bangelooo/BanSCARA/CAD Model/SCARA-Q2.step

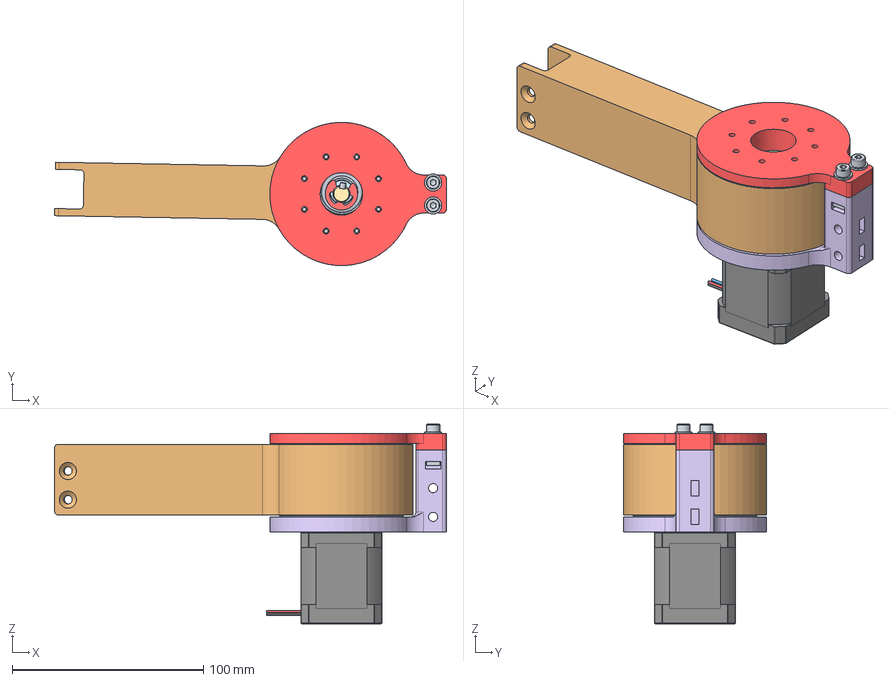
[picture p1: CAD file, 2026-09-29]
CAD Model/SCARA-Q2.step
205.2 x 75.0 x 104.5 mm
4668K163_Permanently Lubricated Stainless Steel Ball Bearing x 20
3m x 40mm LG Pin x 8
Gear Reducer Base
Rotating Module
Top Bracket
17HS19-2004S1 x 3
Square thin nut grade B M4x0.7 x 2
Hex socket head cap screw M3x0.50 x 10
Hex socket head cap screw M4x0.70 x 16 x 2
Conical spring lock washer M4 x 2
Eccentric Shaft
19 Lobe Cycloidal Disc x 2
5972K287_Ball Bearing x 24
Eccentric Roller
Parallel key A x 3 x 3 x 8
Cup point hex socket set screw M3x0.5 x 6
E-Ring - 9mm Shaft
Square thin nut grade B M3x0.5
