bangelooo/BanSCARA/CAD Model/SCARA-Q1.step

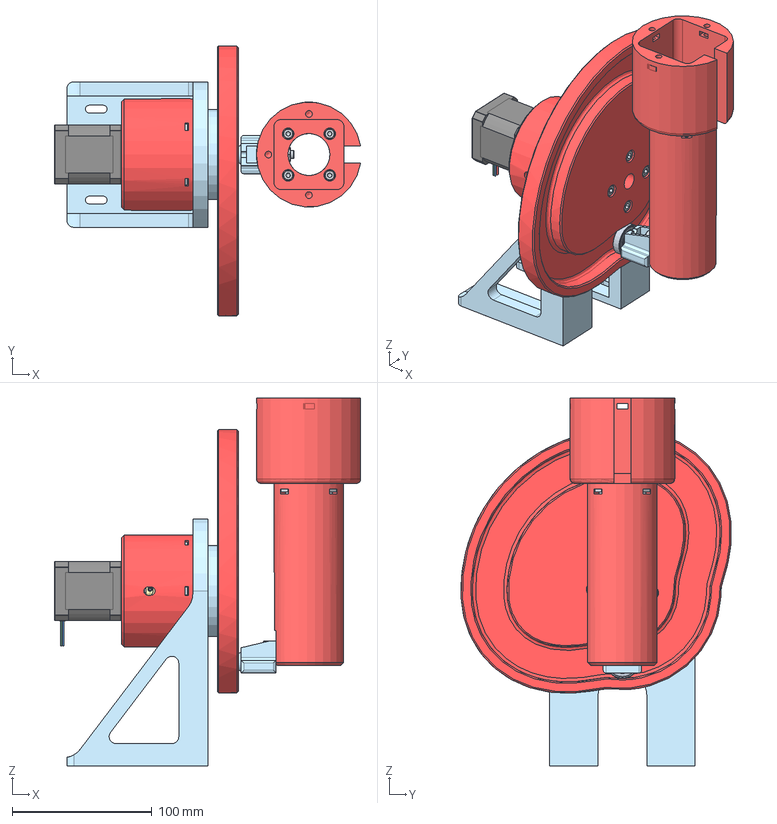
[picture p2: CAD file, 2026-09-29]
CAD Model/SCARA-Q1.step
219.0 x 193.1 x 263.0 mm
Spring lock washer A4 x 7
Spring lock washer A5 x 7
Hex socket head cap screw M4x0.70 x 10 x 7
Hex socket head cap screw M5x0.80 x 16 x 7
Hex socket head cap screw M3x0.50 x 12 x 6
Cycloidal Motion Cam
Spring lock washer A3 x 2
BRKT,GB,CYCL,Q1
ruthex RX-M5x9,5 x 4
ADPT,GB-TO-CAM
Hex socket head cap screw M4x0.70 x 16 x 4
Square thin nut grade B M4x0.7 x 4
Z-Shaft
Hex nut grade A & B M6x1
E-Ring - 9mm Shaft x 2
5972K287_Ball Bearing x 48
Hex socket head cap screw M6x1.00 x 16
Cam follower 2
Coupling | q2 to Z-Shaft
3m x 40mm LG Pin x 8
Square thin nut grade B M3x0.5 x 7
Stator-Base
93448A109_Low-Clearance External Retaining Rings
98455A124_Internal Retaining Ring
Cup point hex socket set screw M3x0.5 x 6
19 Lobe Cycloidal Disc x 2
Eccentric Shaft
Parallel key A x 3 x 3 x 8
Eccentric Roller
17HS19-2004S1 x 3
Hex socket head cap screw M3x0.50 x 8
Rotor - Bottom
4668K163_Permanently Lubricated Stainless Steel Ball Bearing x 10
RX-M4x8.1 x 4
Rotor - Top
