bangelooo/BanSCARA/CAD Model/SCARA-Q4.step

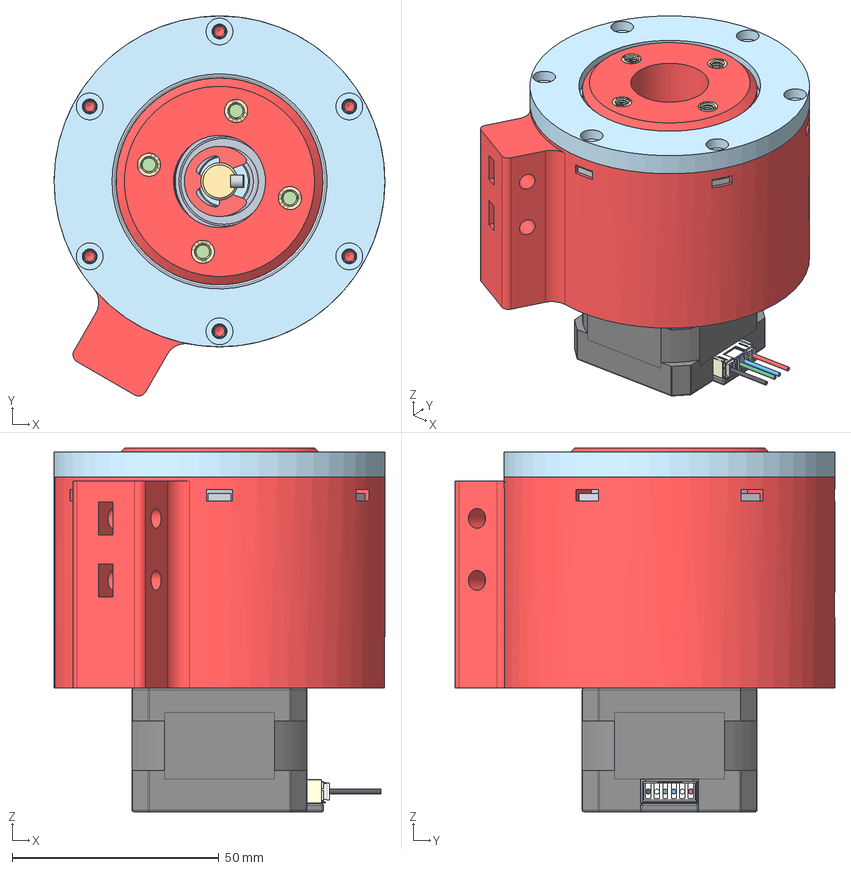
[picture p3: CAD file, 2026-09-29]
CAD Model/SCARA-Q4.step
80.0 x 91.9 x 88.0 mm
3m x 40mm LG Pin x 8
Square thin nut grade B M3x0.5 x 7
17HE12-1204S
93448A109_Low-Clearance External Retaining Rings
98455A124_Internal Retaining Ring
5972K287_Ball Bearing x 36
RX-M4x8.1 x 4
Rotor - Top
Rotor - Bottom
Stator-Base
Eccentric Shaft
Cup point hex socket set screw M3x0.5 x 6
Eccentric Roller
Parallel key A x 3 x 3 x 8
E-Ring - 9mm Shaft
19 Lobe Cycloidal Disc x 2
4668K163_Permanently Lubricated Stainless Steel Ball Bearing x 10
