bangelooo/BanSCARA/CAD Model/End Effector.step

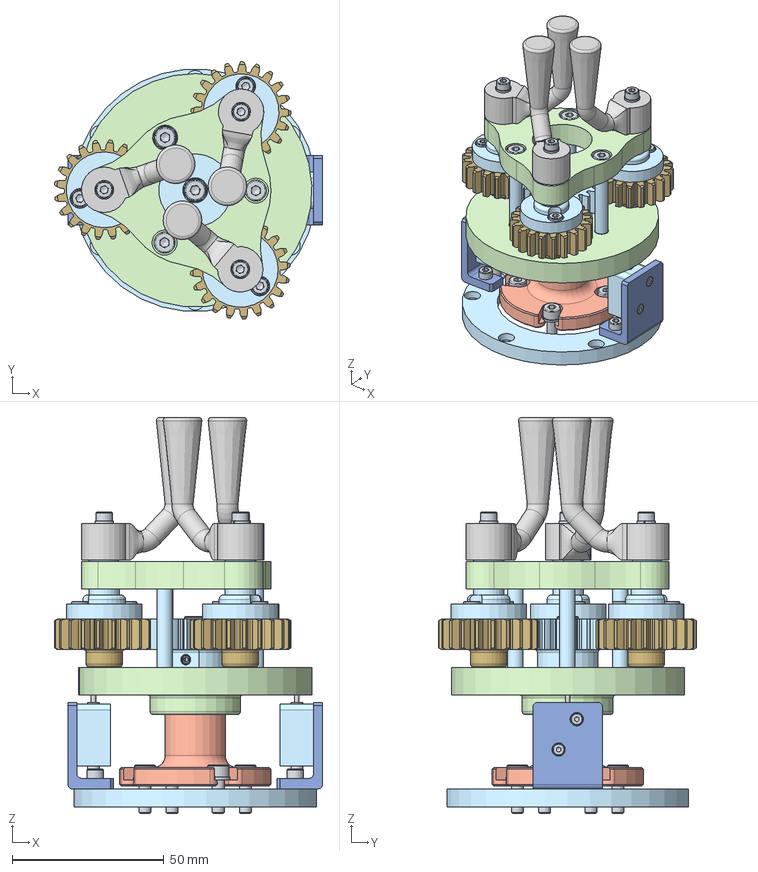
[picture p4: CAD file, 2026-09-29]
CAD Model/End Effector.step
88.4 x 84.9 x 130.6 mm
Hex socket head cap screw M4x0.70 x 12 x 5
Hex socket head cap screw M3x0.50 x 10 x 9
Hex socket head cap screw M2x0.40 x 4 x 4
Cup point hex socket set screw M3x0.5 x 6
Spring lock washer A3 x 9
Spring lock washer A4 x 9
Spur gear (20 teeth) x 4
Square thin nut grade B M3x0.5
5972K287_Ball Bearing x 12
EE - Base Flange V2
RX-M4x8.1 x 4
ruthex RX-M3-5,7 x 13
Finger Base x 3
Finger x 3
Hex socket head cap screw M3x0.50 x 5 x 4
Solenoid Body x 2
Solenoid Shaft x 2
Bracket x 2
END EFFECTOR COVER
Square thin nut grade B M4x0.7 x 3
Hex socket head cap screw M4x0.70 x 40 x 20 x 3
Planet Carrier Bottom
Planet Carrier Spacer x 3
Hex socket head cap screw M4x0.70 x 20 x 3
Planet Carrier
