bangelooo/BanSCARA/CAD Model/Robot.step

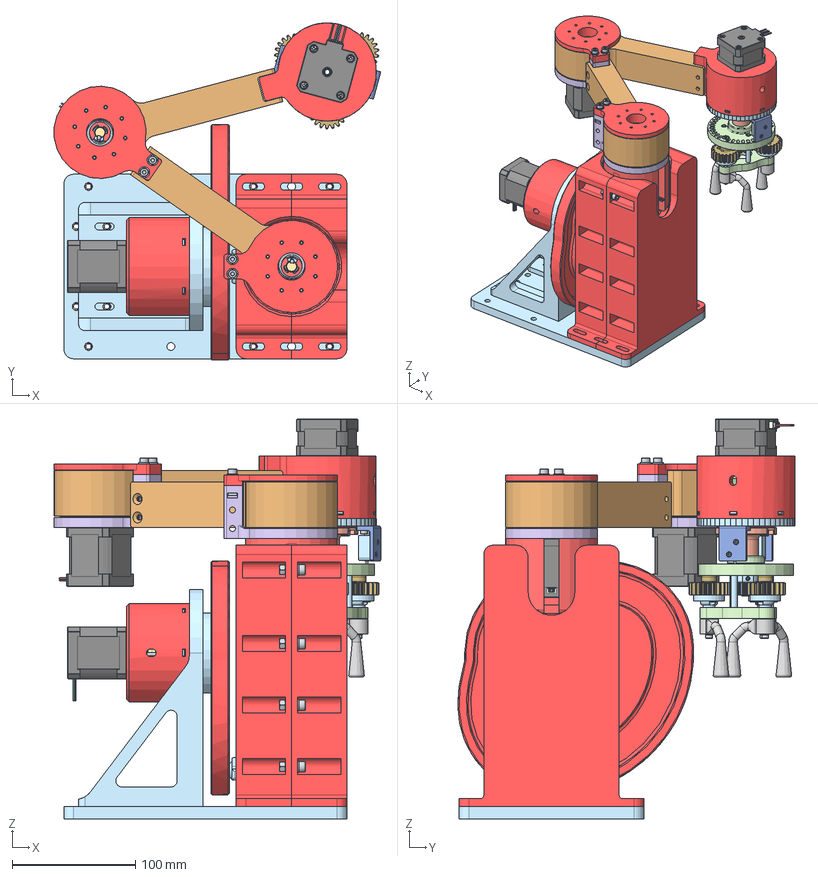
[picture p5: CAD file, 2026-09-29]
CAD Model/Robot.step
265.4 x 274.1 x 325.0 mm
Conical spring lock washer M4 x 4
Hex socket head cap screw M3x0.50 x 10 x 17
17HS19-2004S1 x 9
3m x 40mm LG Pin x 32
4668K163_Permanently Lubricated Stainless Steel Ball Bearing x 60
Square thin nut grade B M4x0.7 x 11
Hex socket head cap screw M4x0.70 x 16 x 8
Top Bracket x 2
Gear Reducer Base x 2
Rotating Module x 2
5972K287_Ball Bearing x 144
Cup point hex socket set screw M3x0.5 x 6 x 5
Eccentric Roller x 4
19 Lobe Cycloidal Disc x 8
E-Ring - 9mm Shaft x 5
Eccentric Shaft x 4
Square thin nut grade B M3x0.5 x 17
Parallel key A x 3 x 3 x 8 x 4
17HE12-1204S
98455A124_Internal Retaining Ring x 2
Rotor - Bottom x 2
93448A109_Low-Clearance External Retaining Rings x 2
Rotor - Top x 2
RX-M4x8.1 x 12
Stator-Base x 2
Hex nut style 1 grade A & B M5x0.8 x 8
Spring lock washer A5 x 15
Hex socket head cap screw M5x0.80 x 16 x 15
Housing-Back
Housing-Front
ruthex RX-M5x9,5 x 20
BASE PLATE
Hex socket head cap screw M4x0.70 x 10 x 7
Hex socket head cap screw M3x0.50 x 12 x 6
Spring lock washer A4 x 16
Spring lock washer A3 x 11
BRKT,GB,CYCL,Q1
Cycloidal Motion Cam
Coupling | q2 to Z-Shaft
Z-Shaft
Hex nut grade A & B M6x1
Hex socket head cap screw M6x1.00 x 16
Cam follower 2
ADPT,GB-TO-CAM
Hex socket head cap screw M3x0.50 x 8
Hex socket head cap screw M2x0.40 x 4 x 4
Spur gear (20 teeth) x 4
Hex socket head cap screw M4x0.70 x 12 x 5
EE - Base Flange V2
Hex socket head cap screw M4x0.70 x 40 x 20 x 3
Hex socket head cap screw M4x0.70 x 20 x 3
Planet Carrier Spacer x 3
Planet Carrier Bottom
Planet Carrier
Hex socket head cap screw M3x0.50 x 5 x 4
Bracket x 2
ruthex RX-M3-5,7 x 13
END EFFECTOR COVER
Solenoid Body x 2
Solenoid Shaft x 2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
