bangelooo/BanSCARA/(list of files, cad)

Other CAD files:
CAD Model/SCARA-Q3.step
