bangelooo/BanSCARA/SCARA_PCB/SCARA_PCB.pdf

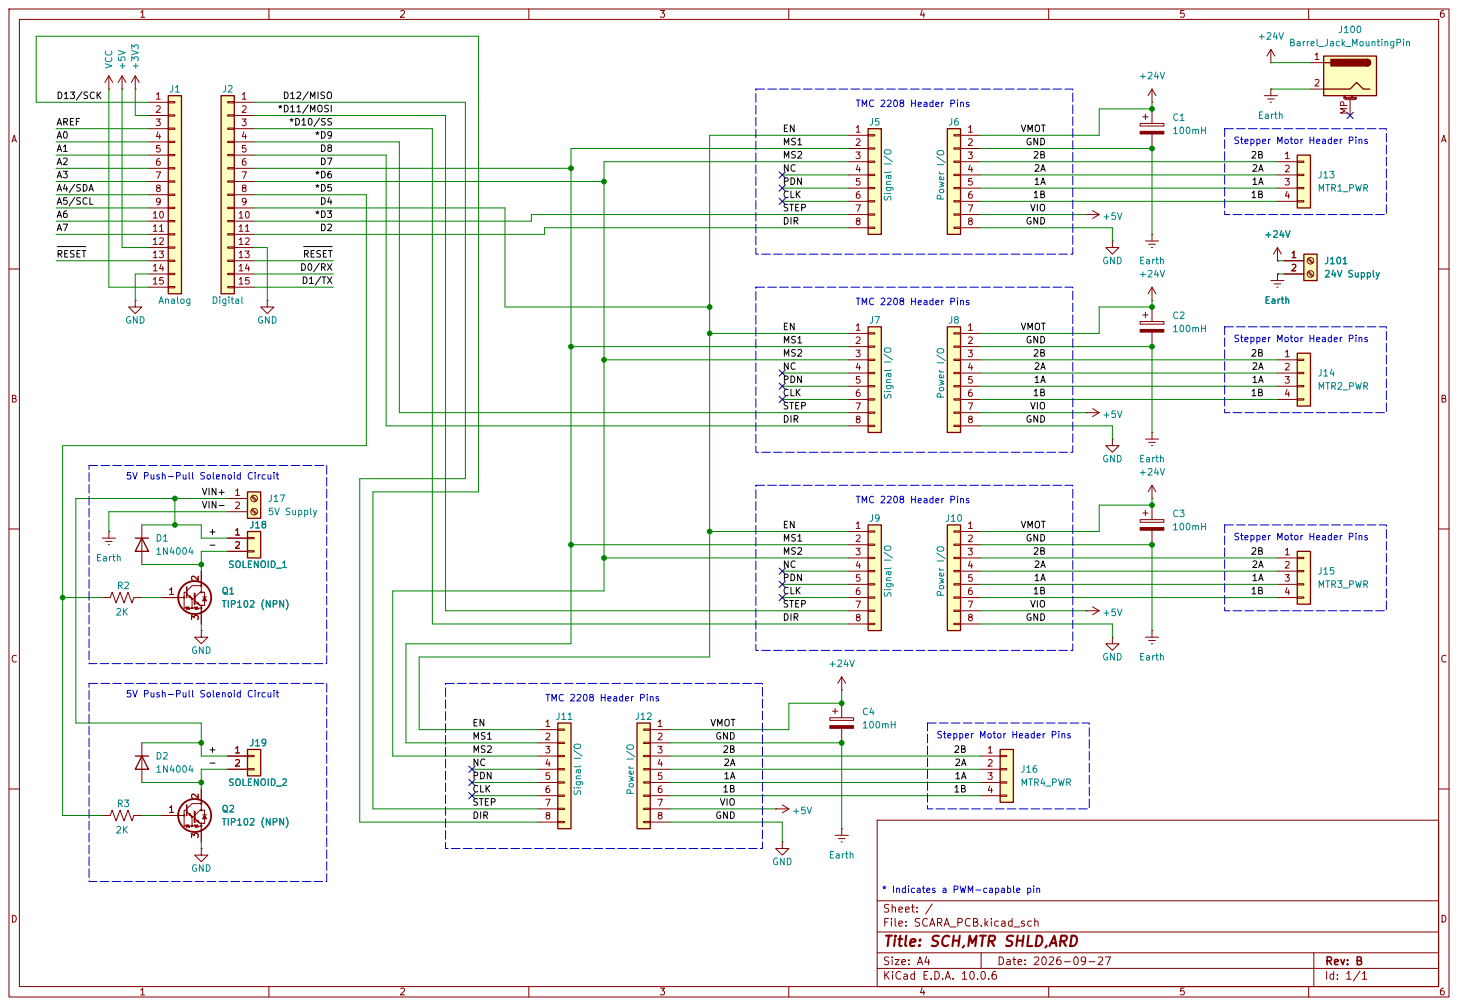
[picture p6: page 1]

Stepper Motor Header Pins 5V Push-Pull Solenoid Circuit

10 *D3
11 12

Stepper Motor Header Pins

1B | 1B
VIO

* Indicates a PWM-capable pin
Sheet: /
File: SCARA_PCB.kicad_sch
Title: SCH,MTR SHLD,ARD

Size: A4 | Rev: B
KiCad E.D.A. 10.0.6 | Id: 1/1
