bangelooo/BanSCARA/SCARA_PCB/SCARA_PCB.kicad_pcb

## KiCad design SCARA_PCB/SCARA_PCB.kicad_pcb (2026-09-29)

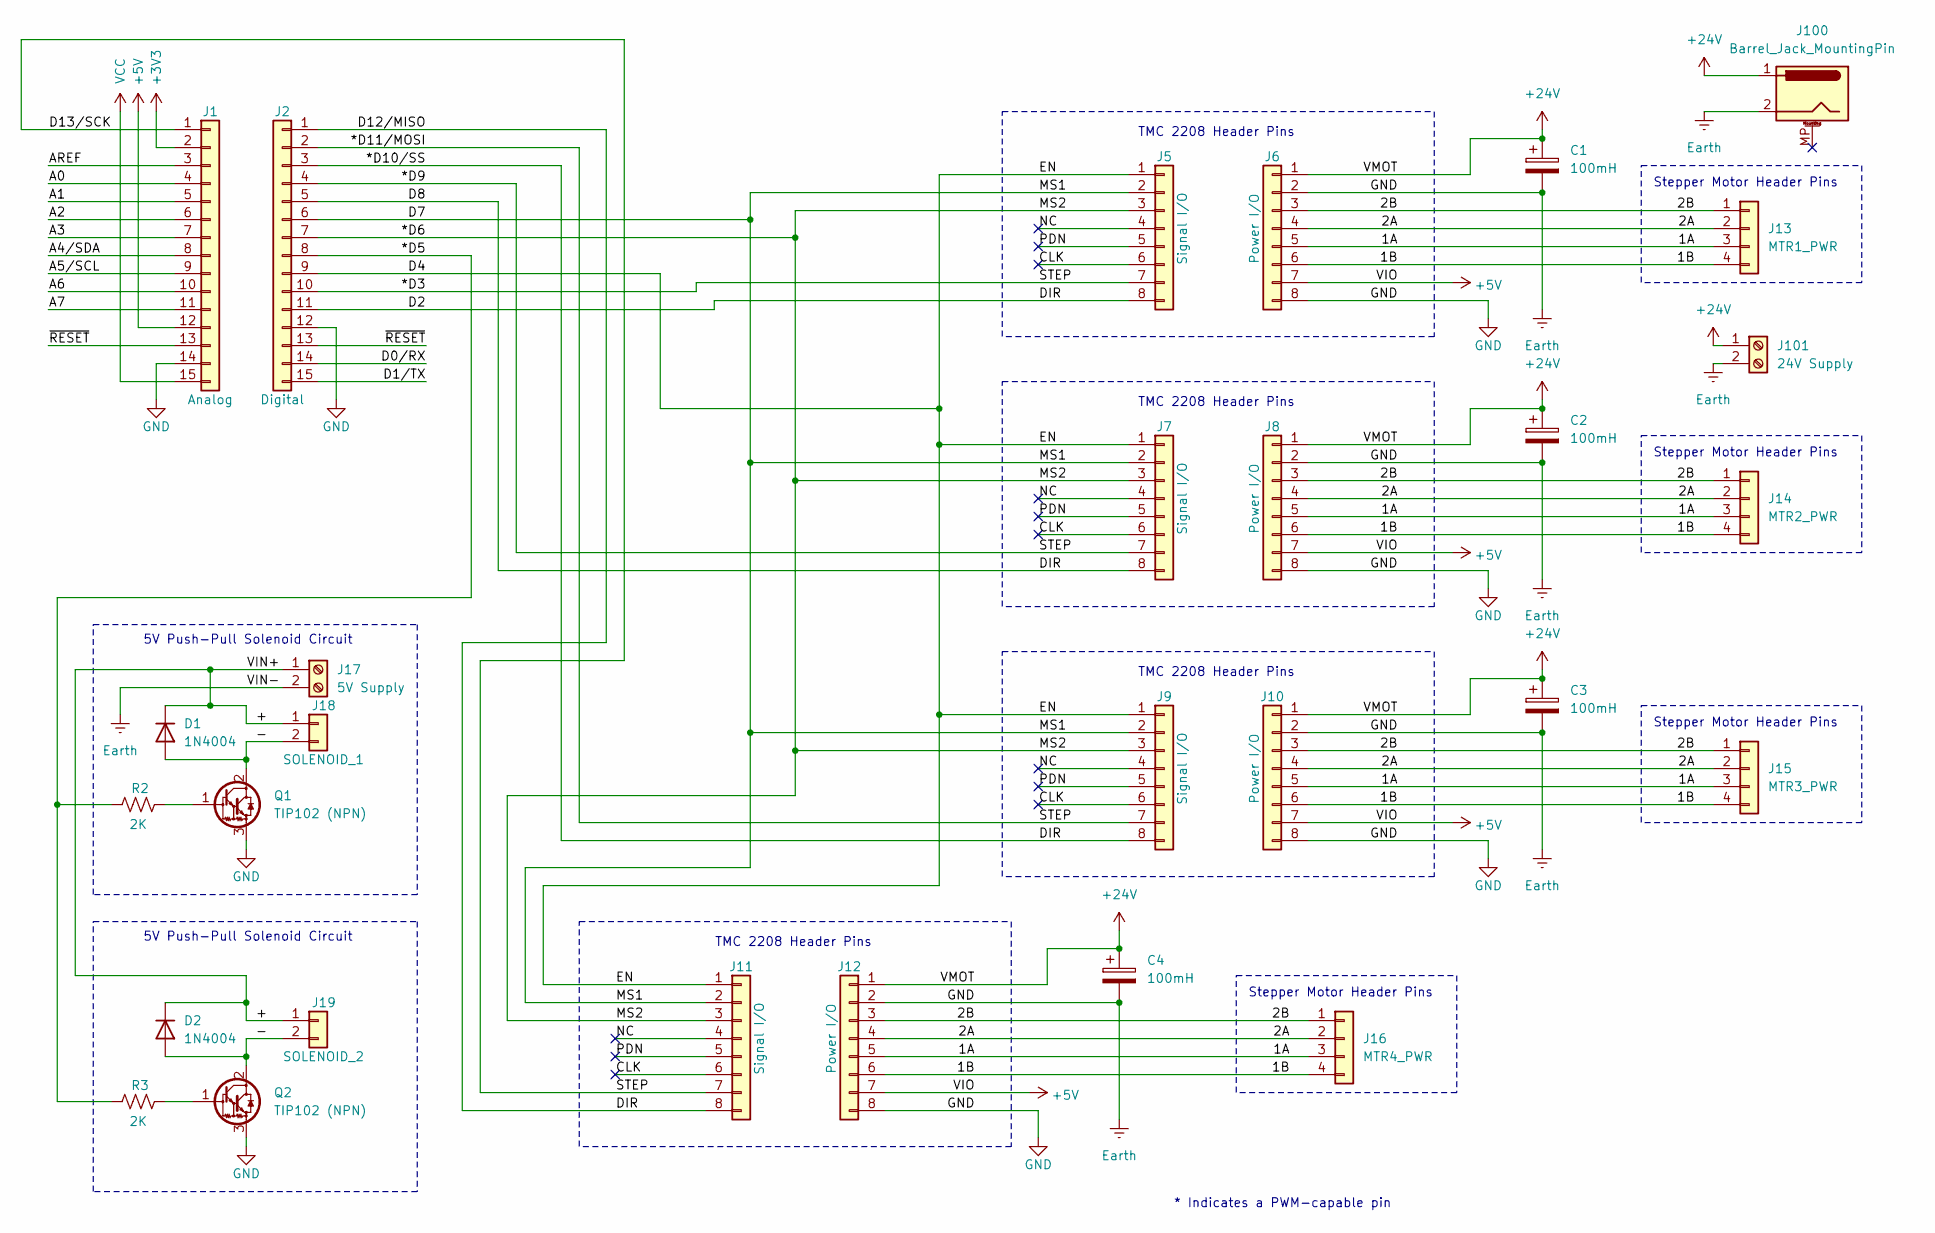
[picture p7: schematic SCARA_PCB.kicad_sch, SCH,MTR SHLD,ARD]

Parts:
C1, C2, C3, C4: 100mH
D1, D2: 1N4004
J1: Analog; PinSocket_1x15_P2.54mm_Vertical
J2: Digital; PinSocket_1x15_P2.54mm_Vertical
J5, J7, J9, J11: Signal I/O; PinSocket_1x08_P2.54mm_Vertical
J6, J8, J10, J12: Power I/O; PinSocket_1x08_P2.54mm_Vertical
J13: MTR1_PWR
J14: MTR2_PWR
J15: MTR3_PWR
J16: MTR4_PWR
J17: 5V Supply
J18: SOLENOID_1
J19: SOLENOID_2
J100: Barrel_Jack_MountingPin; BarrelJack_CUI_PJ-102AH_Horizontal
J101: 24V Supply
Q1, Q2: TIP102 (NPN); TO-220-3_Vertical
R2, R3: 2K

Connections:
+3V3: J1.2
+5V: J1.12, J6.7, J8.7, J10.7, J12.7
+24V: C1.1, C2.1, C3.1, C4.1, J6.1, J8.1, J10.1, J12.1, J100.1, J101.1
/1A: J6.5, J8.5, J10.5, J12.5, J13.3, J14.3, J15.3, J16.3
/1B: J6.6, J8.6, J10.6, J12.6, J13.4, J14.4, J15.4, J16.4
/2A: J6.4, J8.4, J10.4, J12.4, J13.2, J14.2, J15.2, J16.2
/2B: J6.3, J8.3, J10.3, J12.3, J13.1, J14.1, J15.1, J16.1
/*D5: J2.8, R2.2, R3.2
/*D6: J2.7, J5.3, J7.3, J9.3, J11.3
/*D10/SS: J2.1, J2.3, J2.5, J2.11, J5.8, J7.8, J9.8, J11.8
/*D11/MOSI: J1.1, J2.2, J2.4, J2.10, J5.7, J7.7, J9.7, J11.7
/+: D1.1 (K), D2.1 (K), J17.1, J18.1, J19.1
/-: D1.2 (A), D2.2 (A), J18.2, J19.2, Q1.2 (C), Q2.2 (C)
/A0: J1.4
/A1: J1.5
/A2: J1.6
/A3: J1.7
/A4/SDA: J1.8
/A5/SCL: J1.9
/A6: J1.10
/A7: J1.11
/AREF: J1.3
/CLK: J5.6, J7.6, J9.6, J11.6
/D0/RX: J2.14
/D1/TX: J2.15
/D4: J2.9, J5.1, J7.1, J9.1, J11.1
/D7: J2.6, J5.2, J7.2, J9.2, J11.2
/NC: J5.4, J7.4, J9.4, J11.4
/PDN: J5.5, J7.5, J9.5, J11.5
/~RESET: J1.13, J2.13
Earth: C1.2, C2.2, C3.2, C4.2, J1.14, J2.12, J6.2, J6.8, J8.2, J8.8, J10.2, J10.8, J12.2, J12.8, J17.2, J100.2, J101.2, Q1.3 (E), Q2.3 (E)
unnamed: Q1.1 (B), R2.1
unnamed: Q2.1 (B), R3.1
VCC: J1.15

Notes on the sheet:
TMC 2208 Header Pins
5V Push-Pull Solenoid Circuit
Stepper Motor Header Pins
* Indicates a PWM-capable pin

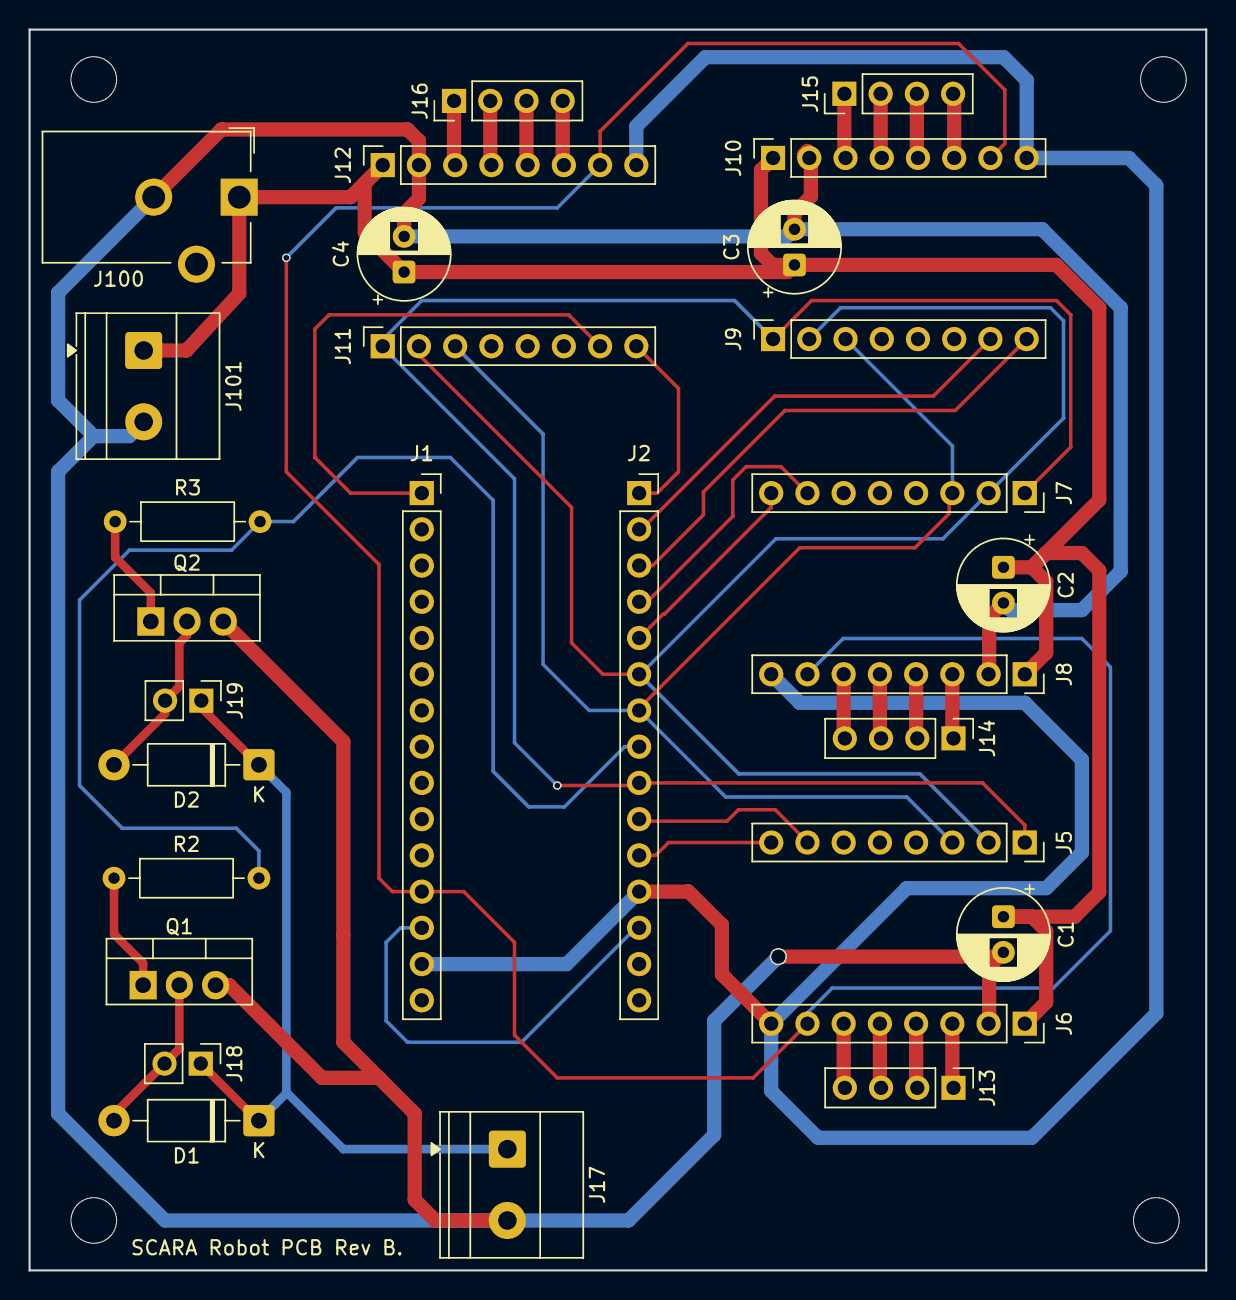
[picture p8: board SCARA_PCB.kicad_pcb from above]

Board: 2 copper layers, 82.5 x 87.0 mm, 33 parts (0 on the bottom side), 21 nets.

Other parts of the board:
MH1, MH2, MH3, MH4: MountingHole_3.2mm
