bangelooo/BanSCARA/(commit log)

2025-05-27 Single stepper motor control
2025-06-02 Code for controlling two stepper motors. Need to fix cycling.
    Cycling currently repeats 5 times, twice.
    [dualStepperMotorControl.ino]
2025-06-11 Forward kinematics for SCARA robot.
    The forward kinematics for this SCARA robot was developed using the Elementary Transformation Sequence (ETS) proposed by Peter Corke. The code will have to be modified to fully function in the Arduino environment.
    main.cpp in the Backup folder has both the ET and ETS classes included.
2025-08-02 SCARA Controller Version 0.1
    The user has the ability to send string commands to control 3 joints of the SCARA robot. The moves available are relative and absolute. Q1 = Z-axs, Q2 = Revolute Joint 1, Q2 = Revolute Joint 2.
    A string parse function is used set command positions.
    Current version does not support velocity setpoints.
    Known Issue: After performing relative move, the robot will move to its absolute position if an ABS move is called and the robot joint is not called.
    [SCARAcontroller.ino, axisPar.cpp, axisPar.h, motorBasic.cpp, motorBasic.h]
2025-12-23 Fix single axis relative move commands
    After relative move is complete, the motor will go back to last absolute position if ABS is commanded.
    This problem has been resolved for a single axis, but commanding multiple axis moves causes all motors to repeat the relative moves
    [SCARAcontroller.ino, axisPar.cpp, axisPar.h, motorBasic.cpp, motorBasic.h]
2025-12-24 Fix relative move so it does not repeat unless a new command has been issued.
    [motorBasic.cpp]
2026-01-03 Re-orgnize class. Include Robot Pose Info
    Added class attributes and methods to update the robot's pose after a joint update.
2026-01-27 Trajectory Planning
    Cubic Polynomial, Linear with Parabolic Blend (Time Specification), Trapezoidal Trajectory (Velocity and Motion Rule specification)
2026-02-16 Update RobotGUI, RobotCommunications, RobotArmLibrary, and Trajectory Plaanning
    Fix logic in RobotGUI,RobotCommunications,RobotArmLibrary, and TrajectoryPlanning modules.
    [RobotArmLibrary.py, RobotCommunications.py, TrajectoryPlanning.py, robotGUI.py]
2026-02-28 Add 4th motor. Add motor on and motor off logic.
2026-03-01 Update homing/calibration/indexing logic and velocity move logic
2026-03-08 Add Direct homing/calibration/indexing feature on GUI,Controller, and Arduino
2026-03-30 Add End Effector Gripping Function (preliminary)
    - Update Arduino Code, GUI Code, and Controller Code to perfrom internal gripping operation.
2026-03-30 Release Object Functionality (Preliminary)
    Update Arduino, GUI and Controller for Object Release Functionality (Minimal)
2026-04-03 Feature: LED Color during Indexing/Calibration/Homing
2026-04-04 Correct Q1 absolute and relative moves in Joint Space.
    [RobotArmLibrary.py, cam.py, robotGUI.py]
2026-04-04 Correct Cartesian Space Commands
    Can now command and jog all axes in Cartesian Space
    [RobotArmLibrary.py]
2026-04-11 Add ACK/NACK to Arduino. Update send() method in RobotController.
2026-04-14 Grip diameter publisher/subscriber added to GUI. Added default routine for robotController class.
    Updated Action Client for thread safety. Can now create a C-Space routine for the robot without race conditions.
2026-09-29 Upload PCB Design - Rev B for SCARA Robot
    [SCARA_PCB.kicad_pcb, SCARA_PCB.kicad_sch]
2026-09-29 Upload CAD Model of SCARA Robot
    [Robot.step]
2026-09-29 Upload CAD Models - Q1 to Q4 - End Effector
    [End Effector.step, SCARA-Q1.step, SCARA-Q2.step, SCARA-Q3.step, SCARA-Q4.step]
